Vaaxs/solarCharger/P1&P2model.stp

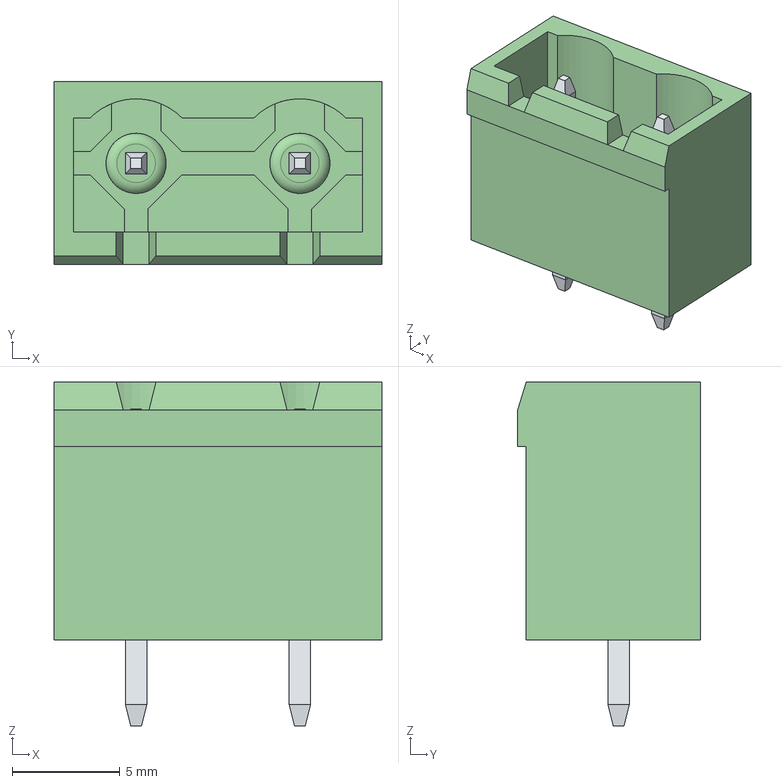
[picture p10: CAD file, 2026-10-13]
P1&P2model.stp
15.2 x 8.50 x 16.0 mm
6913114001xx_PIN x 2
