Vaaxs/solarCharger/SW_CK-Components_OS102011MS2QS1_Slide_TH.STEP

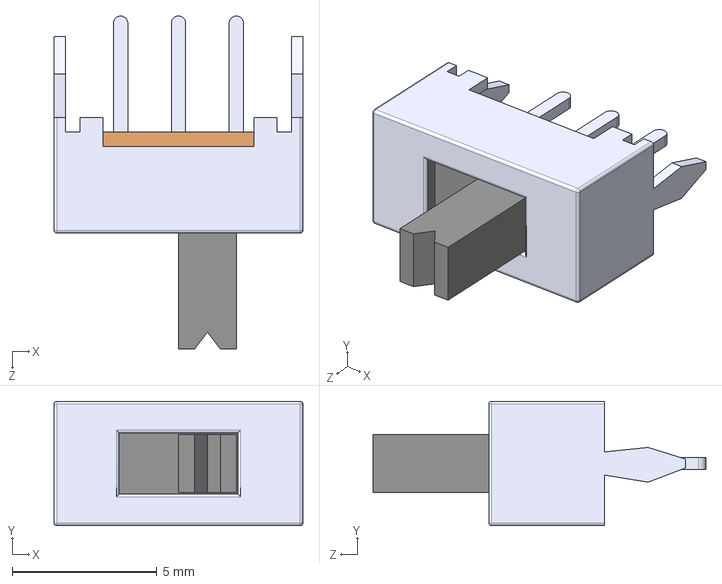
[picture p11: CAD file, 2026-10-13]
SW_CK-Components_OS102011MS2QS1_Slide_TH.STEP
8.60 x 4.30 x 11.5 mm
