Vaaxs/solarCharger/pcb3dmodel.step

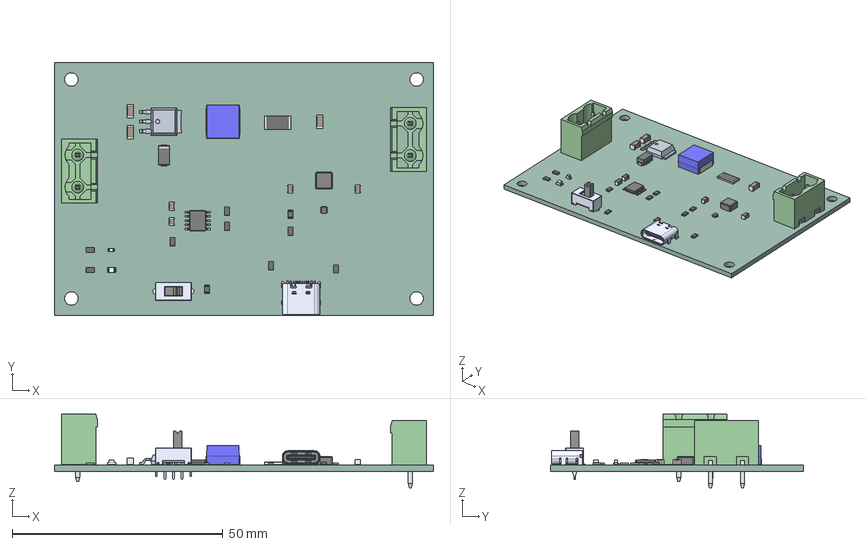
[picture p12: CAD file, 2026-10-13]
pcb3dmodel.step
90.0 x 60.0 x 17.5 mm
R_0805_2012Metric x 10
LED_0805_2012Metric
R_2512_6332Metric
FilletPin1
FilletPin2
C_1206_3216Metric x 3
C_0805_2012Metric x 4
core
t1 x 2
SSOP-10_3.9x4.9mm_P1.00mm
TYPE-C-31-M-12
pcb3dmodel 1.14.1
SW_CK-Components_OS102011MS2QS1_Slide_TH
6913114001xx_PIN x 4
SOT-563
LED_0603_1608Metric
D_SMA
Solar charger 3_PCB
