Vaaxs/solarCharger/SRN8040TA-151M.stp

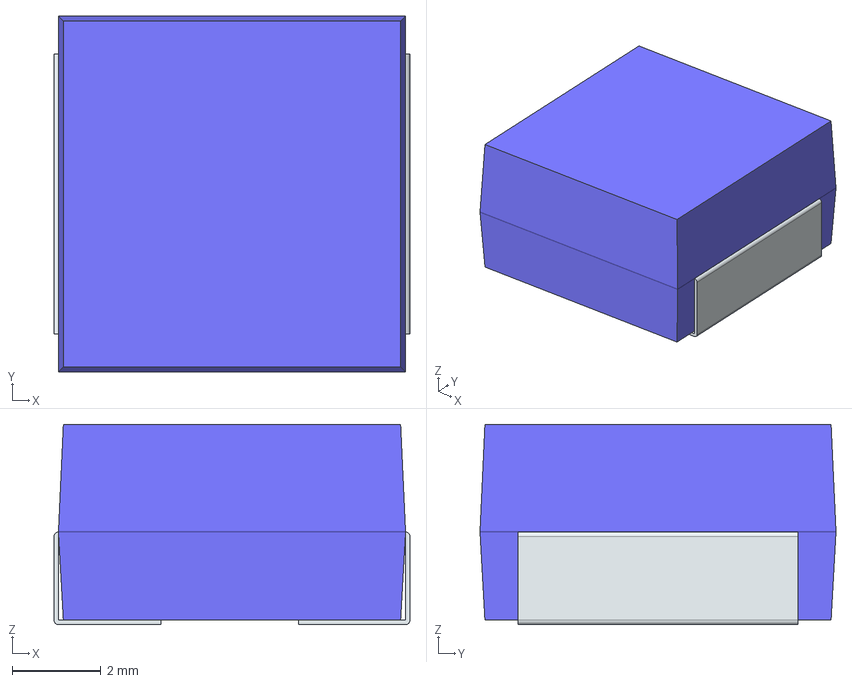
[picture p13: CAD file, 2026-10-13]
SRN8040TA-151M.stp
8.00 x 8.00 x 4.50 mm
FilletPin1
FilletPin2
