Vaaxs/solarCharger/Solar charger 3.kicad_pcb

## KiCad design Solar charger 3.kicad_pcb (2026-10-13)

Schematic: Solar charger 3.kicad_sch

Parts:
C1: 100nF; C_0805_2012Metric
C2: 220nF; C_0805_2012Metric
C5: 22uF; C_0805_2012Metric
C6, C7: 10uF/25V; C_1206_3216Metric
C8: 22uF; C_1206_3216Metric
C9: 10uF; C_0805_2012Metric
D1: SS34_C8678; D_SMA; MPN SS34; LCSC C8678
L1: 10uH SRN8040TA-100M; L_Bourns_SRN8040TA; MPN SWPA4030S100MT; LCSC C38117
L2: 2.2uH NR4018T2R2M; L_Taiyo-Yuden_NR-40xx; MPN SMNR4020-2.2UH; LCSC C135262
LED1: KT-0603R; LED_0603_1608Metric; MPN KT-0603R; LCSC C2286
LED2: LED (yellow-green); LED_0805_2012Metric; MPN 发光二极管（黄绿色）; LCSC C28105
P1, P2: WJ25C-B-2P; TerminalBlock_Wuerth_691311400102_P7.62mm; MPN WJ25C-B-7.62-02P-13-00A; LCSC C8422
Q1: AOD4185; TO-252-3_TabPin2; MPN AOD4185; LCSC C2564
R1: 357k; R_0805_2012Metric
R2, R12, R15: 100k; R_0805_2012Metric
R3, R4: 1k; R_0805_2012Metric
R5: 0.05R; R_2512_6332Metric
R9, R16: 56k; R_0805_2012Metric
R14: 750k; R_0805_2012Metric
R17: 120R; R_0805_2012Metric
SW1: OS102011MS2Q; SW_Slide_1P2T_CK_OS102011MS2Q; MPN SSSS811101; LCSC C109335
U1: CN3791; SSOP-10_3.9x4.9mm_P1.00mm; MPN CN3791; LCSC C154992
U2: TPS61023DRLR; SOT-563; MPN TPS61023DRLR; LCSC C919459
U3: USB-C 16P; USB_C_Receptacle_XKB_U262-16XN-4BVC11; MPN USB-TYPE-C-019; LCSC C2927039

Connections:
+5V: C5.1, R9.1, R14.1, R16.1, U2.6 (VOUT), U3.A4, U3.A9, U3.B4, U3.B9
CHRG_STATE: LED1.2 (K), U1.3 (~CHRG)
COM: C2.1, U1.5 (COM)
CSP: L1.2, R5.1, U1.8 (CSP)
DONE_STATE: LED2.1 (K), U1.4 (~DONE)
DRV: Q1.1 (G), U1.10 (DRV)
EN_BOOST: R12.1, SW1.1, U2.2 (EN)
FB: R14.2, R15.1, U2.1 (FB)
GND: C5.2, C6.2, C7.2, C8.2, C9.2, D1.2 (A), P1.2, P2.2, R2.2, R12.2, R15.2, R17.2, U1.2 (GND), U2.4 (GND), U3.A1, U3.A12, U3.B1, U3.B12, U3.S1 (1)
unnamed: C2.2, R17.1
unnamed: D1.1 (K), L1.1, Q1.2 (D)
unnamed: LED1.1 (A), R3.2
unnamed: LED2.2 (A), R4.2
unnamed: R9.2, U3.B5
unnamed: R16.2, U3.A5
unnamed: R1.2, R2.1, U1.6 (MPPT)
unnamed: L2.2, U2.5 (SW)
VBAT: C8.1, C9.1, L2.1, P2.1, R5.2, SW1.2, U1.7 (BAT), U2.3 (VIN)
VG: C1.2, U1.1 (VG)
VIN_SOLAR: C1.1, C6.1, C7.1, P1.1, Q1.3 (S), R1.1, R3.1, R4.1, U1.9 (VCC)

Notes on the sheet:
PROTOFLOW_REGION:eyJpZCI6ImZpbmFsLXNlY3Rpb24tN2VmNmU0ZjEyYzEzYjk0OSIsIm5hbWUiOiJTb2xhciBNUFBUIENoYXJnZXIiLCJ4MSI6MTkwLjUsInkxIjozNTUuNiwieDIiOjE2NjMuNywieTIiOjE4NzkuNjAwMDAwMDAwMDAwMSwiY29sb3IiOjQyODMyNjkzMjUsImRlc2NyaXB0aW9uIjpudWxsLCJjb21wb25lbnRJZHMiOlsiMDA3ZmI2MDQtN2YyOC00YzA1LTk3ZGMtOTU5OTRkNm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
Status LEDs
56k Rp on CC1/CC2: default USB power
VG bypass
PROTOFLOW_REGION:eyJpZCI6ImZpbmFsLXNlY3Rpb24tODAzZWRlYmQ2ZGFiZTA1MCIsIm5hbWUiOiJVU0ItQyBQb3dlciBPdXRwdXQiLCJ4MSI6MzI2My44OTk5OTk5OTk5OTk2LCJ5MSI6NDE5LjEsIngyIjozODEwLjAsInkyIjoxMDU0LjEsImNvbG9yIjo0MjkxNDAyNTUyLCJkZXNjcmlwdGlvbiI6bnVsbCwiY29tcG9uZW50SWRzIjpbIjA3NzlmN2RlLWNmOWMtNDNkNS04YTJhLWMxNWVkZW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
5V Boost Converter
Vout = 0.595 x (1 + R14/R15) = 5.06 V
COM compensation
Solar MPPT Charger
1S3P Li-ion pack (3x 18650) via external 1S BMS
Slide to pin 1 = ON, pin 3 = OFF
USB-C Power Output
PROTOFLOW_REGION:eyJpZCI6ImZpbmFsLXNlY3Rpb24tNGY1Mzk1ZWU3Zjc3ZWM5NCIsIm5hbWUiOiI1ViBCb29zdCBDb252ZXJ0ZXIiLCJ4MSI6MTkzMC4zOTk5OTk5OTk5OTk5LCJ5MSI6NDE5LjEsIngyIjozMDYwLjcsInkyIjo5NjUuMTk5OTk5OTk5OTk5OSwiY29sb3IiOjQyODkzNjAwNzcsImRlc2NyaXB0aW9uIjpudWxsLCJjb21wb25lbnRJZHMiOlsiYTBlOGQ0OGQtNGMzYi00YWRhLT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
SOLAR PANEL IN
PROTOFLOW_REGION:eyJpZCI6ImZpbmFsLXNlY3Rpb24tMzUyMDgwMmZkZGIzY2FiMyIsIm5hbWUiOiJCYXR0ZXJ5IEJvb3N0IEVuYWJsZSIsIngxIjoxOTU1LjgwMDAwMDAwMDAwMDIsInkxIjoxMDI4LjcsIngyIjoyNjE2LjIsInkyIjoxNTExLjMsImNvbG9yIjo0MjgyNDI3NTA0LCJkZXNjcmlwdGlvbiI6bnVsbCwiY29tcG9uZW50SWRzIjpbIjAwNGQ5YThiLTg1NWQtNGUxMS05ZGVhLWVmNz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
Battery Boost Enable

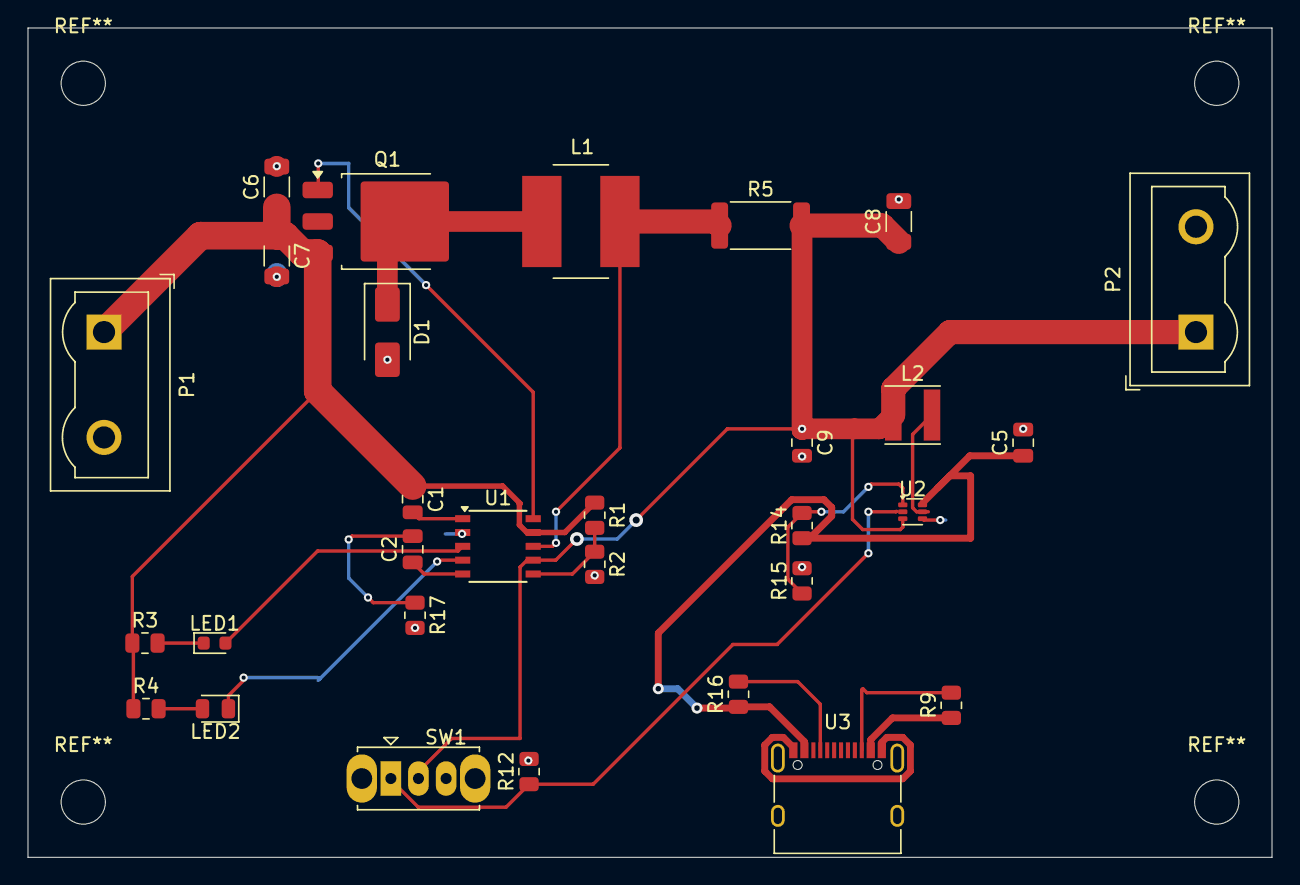
[picture p30: board Solar charger 3.kicad_pcb from above]

Board: 2 copper layers, 90.0 x 60.0 mm, 30 parts (0 on the bottom side), 20 nets.
