Vaaxs/solarCharger/(commit log)

2026-10-13 README, JOURNAL, gitignore and BOM
    Adding all my text files, no project files yet
2026-10-13 Hardware
    schematic, PCB, footprint library and fab outputs
